xqplfly/uart-wifi-transmissible/web_server.ino

// ==================== Web服务器和页面处理 ====================

void initWebServer() {
  if (webServerEnabled && (wifiConnected || currentMode == MODE_SERVER)) {
    webServer.begin();
    if (debugMode) {
      Serial.println("✓ Web服务器启动成功");
      Serial.println("  管理页面已就绪");
    }
  }
}

void handleWebServer() {
  if (!webServerEnabled) return;

  const size_t maxHeaderLength = 1024;
  const size_t maxBodyLength = 1536;
  
  WiFiClient client = webServer.available();
  if (!client) return;
  
  // 先读取请求行和请求头
  String request = "";
  bool headersComplete = false;
  unsigned long startTime = millis();
  
  while (client.connected() && !headersComplete && (millis() - startTime < 500)) {
    if (client.available()) {
      char c = client.read();
      if (request.length() >= maxHeaderLength) {
        client.println("HTTP/1.1 413 Payload Too Large");
        client.println("Connection: close");
        client.println();
        client.stop();
        return;
      }
      request += c;
      
      if (request.length() >= 4 && request.substring(request.length() - 4) == "\r\n\r\n") {
        headersComplete = true;
        break;
      }
    }
    yield();
  }
  
  // 解析Content-Length
  int contentLength = 0;
  int pos = request.indexOf("Content-Length:");
  if (pos >= 0) {
    int pos2 = request.indexOf("\r\n", pos);
    if (pos2 > pos) {
      String lenStr = request.substring(pos + 15, pos2);
      lenStr.trim();
      contentLength = lenStr.toInt();
    }
  }

  if (contentLength > (int)maxBodyLength) {
    client.println("HTTP/1.1 413 Payload Too Large");
    client.println("Connection: close");
    client.println();
    client.stop();
    return;
  }
  
  // 如果是POST请求，继续读取body
  String postBody = "";
  if (contentLength > 0) {
    int bodyStart = request.length();
    while (client.connected() && (millis() - startTime < 500)) {
      if (client.available()) {
        char c = client.read();
        if (postBody.length() >= maxBodyLength) {
          client.println("HTTP/1.1 413 Payload Too Large");
          client.println("Connection: close");
          client.println();
          client.stop();
          return;
        }
        postBody += c;
        if (postBody.length() >= contentLength) break;
      }
      yield();
    }
  }
  
  // 构建完整的请求用于路由
  String requestLine = request;
  int lineEnd = request.indexOf("\r\n");
  if (lineEnd > 0) {
    requestLine = request.substring(0, lineEnd);
  }
  
  // 路由处理
  if (requestLine.indexOf("GET / ") >= 0 || requestLine.indexOf("GET / HTTP") >= 0) {
    handleRootPage(client);
  } else if (requestLine.indexOf("GET /favicon") >= 0) {
    client.println("HTTP/1.1 204 No Content");
    client.println();
  } else if (requestLine.indexOf("GET /hotspot-detect.html") >= 0 || requestLine.indexOf("GET /connecttest.txt") >= 0) {
    client.println("HTTP/1.1 200 OK");
    client.println("Content-Type: text/html");
    client.println();
    client.print("<!DOCTYPE html><html><head><script>window.location.href='http://192.168.1.1/';</script></head><body></body></html>");
  } else if (requestLine.indexOf("GET /generate_204") >= 0 || requestLine.indexOf("GET /fwlink") >= 0) {
    // Android/Windows Captive Portal
    client.println("HTTP/1.1 204 No Content");
    client.println();
  } else if (requestLine.indexOf("GET /ncsi.txt") >= 0) {
    // Windows Captive Portal
    client.println("HTTP/1.1 200 OK");
    client.println("Content-Type: text/plain");
    client.println();
    client.print("Microsoft Connect Test");
  } else if (requestLine.indexOf("GET /serial ") >= 0 || requestLine.indexOf("GET /serial") >= 0) {
    if (requestLine.indexOf("GET /serial/data") >= 0) {
      handleSerialDataAPI(client, requestLine);
    } else {
      handleSerialPage(client);
    }
  } else if (requestLine.indexOf("POST /serial/send") >= 0) {
    handleSerialSend(client, postBody);
  } else if (requestLine.indexOf("POST /serial/clear") >= 0) {
    handleSerialClear(client, postBody);
  } else if (requestLine.indexOf("GET /logs") >= 0) {
    handleLogsPage(client, request);
  } else if (requestLine.indexOf("GET /preview") >= 0) {
    handlePreviewLog(client, request);
  } else if (requestLine.indexOf("GET /status ") >= 0) {
    handleStatusPage(client);
  } else if (requestLine.indexOf("GET /client") >= 0) {
    handleClientPage(client, request);
  } else if (requestLine.indexOf("POST /client/send") >= 0) {
    handleClientSend(client, postBody);
  } else if (requestLine.indexOf("GET /config ") >= 0) {
    handleConfigPage(client);
  } else if (requestLine.indexOf("POST /saveconfig") >= 0) {
    handleSaveConfig(client, postBody);
  } else if (requestLine.indexOf("GET /download") >= 0) {
    handleDownloadLog(client, request);
  } else if (requestLine.indexOf("GET /clear ") >= 0) {
    handleClearLog(client);
  } else if (requestLine.indexOf("GET /deletedir") >= 0) {
    handleDeleteDirectory(client, request);
  } else if (requestLine.indexOf("GET /delete?file=") >= 0) {
    handleDeleteFile(client, request);
  } else if (requestLine.indexOf("POST /power") >= 0) {
    handlePowerControl(client, postBody);
  } else {
    handleNotFound(client);
  }
  
  delay(10);
  client.stop();
  yield();
}

void handleRootPage(WiFiClient client) {
  String html = "HTTP/1.1 200 OK\r\nContent-Type: text/html\r\n\r\n";
  html += "<!DOCTYPE html><html><head><meta charset='UTF-8'>";
  html += "<meta name='viewport' content='width=device-width, initial-scale=1.0, user-scalable=yes'>";
  html += "<title>ESP32 UART 服务器</title>";
  html += "<style>body{font-family:Arial,sans-serif;margin:10px;background:#f5f5f5;font-size:14px;}";
  html += ".container{max-width:100%;margin:0 auto;background:white;padding:12px;border-radius:10px;box-sizing:border-box;box-shadow:0 2px 8px rgba(0,0,0,0.1);}";
  html += "h1{color:#333;border-bottom:2px solid #4CAF50;padding-bottom:8px;font-size:18px;}";
  html += "h2{font-size:16px;}";
  html += "h3{font-size:15px;}";
  html += ".menu{margin:15px 0;display:flex;flex-wrap:wrap;gap:8px;}";
  html += ".menu a{display:block;padding:10px 12px;margin:0;background:#4CAF50;color:white;text-decoration:none;border-radius:4px;text-align:center;font-size:13px;flex:1 1 100px;transition:all 0.2s ease;}";
  html += ".menu a:hover{background:#45a049;transform:translateY(-1px);box-shadow:0 2px 5px rgba(0,0,0,0.2);}";
  html += ".info{background:#e7f3fe;border-left:4px solid #2196F3;padding:10px;margin:12px 0;font-size:13px;}";
  html += "strong{font-size:14px;}";
  html += ".power-controls{display:flex;flex-wrap:wrap;gap:8px;margin-top:10px;}";
  html += ".power-controls form{flex:1 1 80px;}";
  html += ".power-controls input[type='submit']{width:100%;padding:6px 10px;border:none;border-radius:4px;background:#2196F3;color:white;font-size:12px;cursor:pointer;transition:all 0.2s ease;}";
  html += ".power-controls input[type='submit']:hover{background:#1976D2;transform:translateY(-1px);}";
  html += "@media screen and (min-width: 600px) {";
  html += ".container{max-width:800px;padding:15px;}";
  html += ".menu a{flex:none;margin:5px;}";
  html += ".power-controls form{flex:none;width:auto;}";
  html += ".power-controls input[type='submit']{width:80px;}";
  html += "}";
  html += "@media screen and (max-width: 480px) {";
  html += ".menu a{flex:1 1 100%;font-size:12px;padding:8px 10px;}";
  html += ".container{max-width:95%;padding:10px;}";
  html += "h1{font-size:16px;}";
  html += "h3{font-size:14px;}";
  html += "}";
  html += "</style></head><body>";
  html += "<div class='container'>";
  html += "<h1>📡 ESP32 UART 服务器</h1>";
  html += "<div class='info'>";
  html += "<strong>固件版本:</strong> " + String(FIRMWARE_VERSION) + "<br>";
  html += "<strong>运行模式:</strong> " + String(currentMode == MODE_CLIENT ? "客户端" : "服务器") + "<br>";
  html += "<strong>WiFi状态:</strong> " + String(wifiConnected ? "已连接" : "未连接") + "<br>";
  html += "<strong>SD卡状态:</strong> " + String(sdCardReady ? "正常" : "异常") + "<br>";
  html += "<strong>UART1↔UART2透传:</strong> 已启用<br>";  // 透传功能
  html += "</div>";
  html += "<div class='menu'>";
  html += "<a href='/serial'>🖥️ 串口监视器</a>";
  html += "<a href='/logs'>📋 查看日志</a>";
  html += "<a href='/status'>📊 系统状态</a>";
  html += "<a href='/config'>⚙️ 系统配置</a>";
  html += "</div>";
  
  // 电源控制
  html += "<div class='info'>";
  html += "<h3>电源控制</h3>";
  html += "<div class='power-controls'>";
  html += "<form action='/power' method='post'>";
  html += "<input type='hidden' name='action' value='on'>";
  html += "<input type='submit' value='开机'>";
  html += "</form>";
  html += "<form action='/power' method='post'>";
  html += "<input type='hidden' name='action' value='off'>";
  html += "<input type='submit' value='关机'>";
  html += "</form>";
  html += "<form action='/power' method='post'>";
  html += "<input type='hidden' name='action' value='trigger'>";
  html += "<input type='submit' value='触发关机'>";
  html += "</form>";
  html += "<form action='/power' method='post'>";
  html += "<input type='hidden' name='action' value='reset'>";
  html += "<input type='submit' value='复位'>";
  html += "</form>";
  html += "</div>";
  html += "</div>";
  html += "</div>";
  html += "</body></html>";
  client.print(html);
}

void handleLogsPage(WiFiClient client, String request) {
  String html = "HTTP/1.1 200 OK\r\nContent-Type: text/html\r\n\r\n";
  html += "<!DOCTYPE html><html><head><meta charset='UTF-8'>";
  html += "<meta name='viewport' content='width=device-width, initial-scale=1.0, user-scalable=yes'>";
  html += "<title>ESP32 UART 日志</title>";
  html += "<style>body{font-family:Arial,sans-serif;margin:10px;background:#f5f5f5;font-size:14px;}";
  html += ".container{max-width:100%;margin:0 auto;background:white;padding:12px;border-radius:10px;box-sizing:border-box;box-shadow:0 2px 8px rgba(0,0,0,0.1);}";
  html += "h1{color:#333;border-bottom:2px solid #4CAF50;padding-bottom:8px;font-size:18px;}";
  html += "h2{font-size:16px;word-break:break-all;line-height:1.4;margin:10px 0;}";
  html += ".file-list{margin:15px 0;}";
  html += ".file-item{padding:10px;border-bottom:1px solid #eee;display:flex;align-items:center;justify-content:space-between;flex-wrap:wrap;}";
  html += ".file-name{flex:1;min-width:150px;word-break:break-all;overflow:hidden;text-overflow:ellipsis;white-space:nowrap;max-width:0;}";
  html += ".file-name a{text-decoration:none;color:#333;font-size:13px;}";
  html += ".file-name a:hover{color:#4CAF50;}";
  html += ".file-actions{display:flex;gap:8px;flex-shrink:0;margin-left:10px;}";
  html += ".file-actions a{padding:6px 12px;background:#2196F3;color:white;text-decoration:none;border-radius:4px;font-size:12px;transition:all 0.2s ease;}";
  html += ".file-actions a:hover{background:#1976D2;transform:translateY(-1px);}";
  html += ".file-size{color:#666;font-size:12px;margin-left:10px;flex-shrink:0;}";
  html += ".back{margin-top:15px;}";
  html += ".back a{display:inline-block;padding:8px 16px;background:#4CAF50;color:white;text-decoration:none;border-radius:4px;font-size:13px;transition:all 0.2s ease;}";
  html += ".back a:hover{background:#45a049;transform:translateY(-1px);}";
  html += ".breadcrumb{margin:10px 0;padding:8px;background:#f8f8f8;border-radius:4px;font-size:13px;}";
  html += ".breadcrumb a{text-decoration:none;color:#2196F3;}";
  html += ".breadcrumb a:hover{text-decoration:underline;}";
  html += "@media screen and (min-width: 600px) {";
  html += ".container{max-width:800px;padding:15px;}";
  html += "}";
  html += "@media screen and (max-width: 480px) {";
  html += ".file-item{flex-direction:row;align-items:center;}";
  html += ".file-actions{margin-left:auto;}";
  html += ".file-size{margin-left:10px;}";
  html += ".container{max-width:95%;padding:10px;}";
  html += "h1{font-size:16px;}";
  html += "h2{font-size:14px;}";
  html += "}";
  html += "</style></head><body>";
  html += "<div class='container'>";
  html += "<h1>📋 日志文件</h1>";
  html += "<div style='margin:10px 0;'>";
  html += "<a href='/logs?dir=server' style='padding:8px 16px;background:#4CAF50;color:white;text-decoration:none;border-radius:4px;'>服务器日志</a> ";
  html += "<a href='/logs?dir=client' style='padding:8px 16px;background:#2196F3;color:white;text-decoration:none;border-radius:4px;'>客户端日志</a>";
  html += "</div>";
  
  // 检查SD卡状态
  if (!sdCardReady) {
    html += "<div style='background:#ffebee;border-left:4px solid #f44336;padding:15px;margin:15px 0;'>";
    html += "<strong>错误:</strong> SD卡未就绪，无法查看日志文件";
    html += "</div>";
  } else {
    // 解析目录参数
    String currentDir = "/server";
    int dirIndex = request.indexOf("dir=");
    if (dirIndex > 0) {
      int dirEnd = request.indexOf(" ", dirIndex);
      if (dirEnd < 0) dirEnd = request.length();
      String dirParam = request.substring(dirIndex + 4, dirEnd);
      // 规范化：移除可能存在的前导斜杠
      while (dirParam.startsWith("/")) {
        dirParam = dirParam.substring(1);
      }
      // 规范化：移除可能存在的双斜杠
      while (dirParam.indexOf("//") >= 0) {
        dirParam.replace("//", "/");
      }
      // 安全检查：防止路径遍历攻击
      if (dirParam.indexOf("..") == -1) {
        if (dirParam == "client") {
          currentDir = "/client";
        } else if (dirParam == "server") {
          currentDir = "/server";
        } else if (dirParam.startsWith("client/")) {
          currentDir = "/" + dirParam;
        } else if (dirParam.startsWith("server/")) {
          currentDir = "/" + dirParam;
        } else if (dirParam.length() > 0) {
          // 判断是服务器还是客户端的子目录，需要从父路径判断
          // 默认先尝试服务器目录
          if (SD.exists("/server/" + dirParam)) {
            currentDir = "/server/" + dirParam;
          } else if (SD.exists("/client/" + dirParam)) {
            currentDir = "/client/" + dirParam;
          } else {
            // 如果都不存在，默认为客户端目录
            currentDir = "/client/" + dirParam;
          }
        }
      }
    }
    
    // 面包屑导航
    html += "<div class='breadcrumb'>";
    html += "<a href='/logs'>根目录</a>";
    if (currentDir.startsWith("/server")) {
      html += " → <a href='/logs?dir=server'>服务器</a>";
      if (currentDir != "/server") {
        String subPath = currentDir.substring(8); // 去掉 "/server" 前缀
        if (subPath.length() > 0 && subPath != "/") {
          html += " → " + subPath;
        }
      }
    } else if (currentDir.startsWith("/client")) {
      html += " → <a href='/logs?dir=client'>客户端</a>";
      String subPath = currentDir.substring(7); // 去掉 "/client" 前缀
      if (subPath.length() > 0 && subPath != "/") {
        // 移除前导斜杠
        if (subPath.startsWith("/")) {
          subPath = subPath.substring(1);
        }
        html += " → " + subPath;
      }
    }
    html += "</div>";
    
    // 列出当前目录内容
    String displayDir = currentDir;
    if (displayDir.length() > 50) {
      displayDir = "..." + displayDir.substring(displayDir.length() - 47);
    }
    html += "<h2>" + displayDir + "</h2>";
    html += "<div class='file-list'>";
    File root = SD.open(currentDir);
    if (root) {
      bool hasFiles = false;
      
      // 显示返回上级目录链接
      if (currentDir != "/server" && currentDir != "/client") {
        String parentDir = currentDir.substring(0, currentDir.lastIndexOf('/'));
        String parentLink = "";
        if (parentDir == "/server") {
          parentLink = "/logs?dir=server";
        } else if (parentDir == "/client") {
          parentLink = "/logs?dir=client";
        } else if (parentDir.startsWith("/server")) {
          parentLink = "/logs?dir=" + parentDir.substring(8);
        } else {
          parentLink = "/logs?dir=" + parentDir.substring(1);
        }
        html += "<div class='file-item'>";
        html += "<div class='file-name'>";
        html += "<a href='" + parentLink + "'>📁 .. (返回上级)</a>";
        html += "</div>";
        html += "</div>";
      }
      
      while (true) {
        File entry = root.openNextFile();
        if (!entry) break;
        hasFiles = true;
        String entryName = entry.name();
        // 规范化路径：避免产生双斜杠
        String entryPath;
        if (currentDir.endsWith("/")) {
          entryPath = currentDir + entryName;
        } else {
          entryPath = currentDir + "/" + entryName;
        }
        // 移除路径中可能存在的双斜杠
        while (entryPath.indexOf("//") >= 0) {
          entryPath.replace("//", "/");
        }
        String entryUrlPath;
        if (currentDir.startsWith("/server")) {
          entryUrlPath = entryPath.substring(8); // 去掉 "/server" 前缀
        } else {
          entryUrlPath = entryPath.substring(7); // 去掉 "/client" 前缀
        }
        
        if (entry.isDirectory()) {
          html += "<div class='file-item'>";
          html += "<div class='file-name'>";
          html += "<a href='/logs?dir=" + entryUrlPath + "'>📁 " + entryName + "</a>";
          html += "</div>";
          html += "<div class='file-actions'>";
          html += "<a href='/deletedir?dir=" + entryPath + "' onclick='return confirm(\"确定删除文件夹 " + entryName + " 及所有内容？\")' style='background:#f44336;'>删除</a>";
          html += "</div>";
          html += "</div>";
        } else {
          String fileSize = formatFileSize(entry.size());
          html += "<div class='file-item'>";
          html += "<div class='file-name'>📄 " + entryName + "</div>";
          html += "<div class='file-actions'>";
          html += "<a href='/preview?file=" + entryPath + "'>预览</a>";
          html += "<a href='/download?file=" + entryPath + "'>下载</a>";
          html += "<a href='/delete?file=" + entryPath + "' onclick='return confirm(\"确定删除 " + entryName + "？\")'>删除</a>";
          html += "</div>";
          html += "<div class='file-size'>" + fileSize + "</div>";
          html += "</div>";
        }
        entry.close();
      }
      if (!hasFiles) {
        html += "<div class='file-item'><div class='file-name'>空目录</div></div>";
      }
      root.close();
    } else {
      html += "<div style='background:#ffebee;border-left:4px solid #f44336;padding:15px;margin:15px 0;'>";
      html += "<strong>错误:</strong> 无法打开目录: " + currentDir;
      html += "</div>";
    }
    html += "</div>";
  }
  
  html += "<div class='back'><a href='/'>返回首页</a></div>";
  html += "</div>";
  html += "</body></html>";
  client.print(html);
}

void handleStatusPage(WiFiClient client) {
  String html = "HTTP/1.1 200 OK\r\nContent-Type: text/html\r\n\r\n";
  html += "<!DOCTYPE html><html><head><meta charset='UTF-8'>";
  html += "<meta name='viewport' content='width=device-width, initial-scale=1.0, user-scalable=yes'>";
  html += "<title>ESP32 UART 系统状态</title>";
  html += "<style>body{font-family:Arial,sans-serif;margin:10px;background:#f5f5f5;font-size:14px;}";
  html += ".container{max-width:100%;margin:0 auto;background:white;padding:12px;border-radius:10px;box-sizing:border-box;box-shadow:0 2px 8px rgba(0,0,0,0.1);}";
  html += "h1{color:#333;border-bottom:2px solid #4CAF50;padding-bottom:8px;font-size:18px;}";
  html += "h2{font-size:16px;}";
  html += ".status{background:#e7f3fe;border-left:4px solid #2196F3;padding:10px;margin:12px 0;font-size:13px;}";
  html += "strong{font-size:14px;}";
  html += ".back{margin-top:15px;}";
  html += ".back a{display:inline-block;padding:8px 16px;background:#4CAF50;color:white;text-decoration:none;border-radius:4px;font-size:13px;transition:all 0.2s ease;}";
  html += ".back a:hover{background:#45a049;transform:translateY(-1px);}";
  html += "@media screen and (min-width: 600px) {";
  html += ".container{max-width:800px;padding:15px;}";
  html += "}";
  html += "@media screen and (max-width: 480px) {";
  html += ".container{max-width:95%;padding:10px;}";
  html += "h1{font-size:16px;}";
  html += "h2{font-size:14px;}";
  html += "}";
  html += "</style></head><body>";
  html += "<div class='container'>";
  html += "<h1>📊 系统状态</h1>";
  
  // 系统信息
  html += "<div class='status'>";
  html += "<strong>固件版本:</strong> " + String(FIRMWARE_VERSION) + "<br>";
  html += "<strong>运行模式:</strong> " + String(currentMode == MODE_CLIENT ? "客户端" : "服务器") + "<br>";
  html += "<strong>客户端ID:</strong> " + client_id + "<br>";
  html += "<strong>运行时间:</strong> " + String(millis() / 1000) + " 秒<br>";
  html += "</div>";
  
  // WiFi信息
  html += "<div class='status'>";
  html += "<h2>WiFi信息</h2>";
  html += "<strong>状态:</strong> " + String(wifiConnected ? "已连接" : "未连接") + "<br>";
  if (wifiConnected) {
    if (currentMode == MODE_SERVER) {
      html += "<strong>AP SSID:</strong> " + maskSensitiveValue(ap_ssid) + "<br>";
      html += "<strong>AP 地址:</strong> " + maskIpAddress(WiFi.softAPIP()) + "<br>";
      html += "<strong>连接设备数:</strong> " + String(WiFi.softAPgetStationNum()) + "<br>";
    } else {
      html += "<strong>SSID:</strong> " + maskSensitiveValue(client_wifi_ssid) + "<br>";
      html += "<strong>IP地址:</strong> " + maskIpAddress(WiFi.localIP()) + "<br>";
      html += "<strong>信号强度:</strong> " + String(WiFi.RSSI()) + " dBm<br>";
    }
  }
  html += "</div>";
  
  // 串口信息
  html += "<div class='status'>";
  html += "<h2>串口信息</h2>";
  html += "<strong>UART2波特率:</strong> " + String(uart2BaudRate) + "<br>";
  html += "<strong>UART2引脚:</strong> RX=" + String(UART2_RX_PIN) + " TX=" + String(UART2_TX_PIN) + "<br>";
  html += "<strong>UART1波特率:</strong> " + String(uart1BaudRate) + "<br>";
  html += "<strong>UART1引脚:</strong> RX=" + String(UART1_RX_PIN) + " TX=" + String(UART1_TX_PIN) + "<br>";
  html += "</div>";
  
  // SD卡信息
  html += "<div class='status'>";
  html += "<h2>SD卡信息</h2>";
  html += "<strong>状态:</strong> " + String(sdCardReady ? "正常" : "异常") + "<br>";
  if (sdCardReady) {
    uint64_t cardSize = SD.cardSize() / (1024 * 1024);
    uint64_t usedSize = SD.usedBytes() / (1024 * 1024);
    html += "<strong>总容量:</strong> " + String(cardSize) + " MB<br>";
    html += "<strong>已用容量:</strong> " + String(usedSize) + " MB<br>";
  }
  html += "</div>";
  
  // 电池信息
  html += "<div class='status'>";
  html += "<h2>电池信息</h2>";
  html += "<strong>电池电压:</strong> " + String(batteryVoltage) + " V<br>";
  html += "<strong>状态:</strong> " + String(batteryVoltage > BATTERY_LOW_VOLTAGE ? "正常" : "低电压") + "<br>";
  html += "</div>";
  
  // 客户端连接信息（服务器模式）
  if (currentMode == MODE_SERVER) {
    int clientCount = getConnectedClientCount();
    html += "<div class='status'>";
    html += "<h2>客户端连接</h2>";
    html += "<strong>当前连接数:</strong> " + String(clientCount) + "<br>";
    for (int i = 0; i < MAX_CLIENTS; i++) {
      if (serverClients[i] && serverClients[i].connected()) {
        html += "<a href='/client?client_id=" + String(i) + "' style='display:inline-block;padding:8px 12px;background:#4CAF50;color:white;text-decoration:none;border-radius:4px;margin:5px 0;'>";
        html += "客户端 " + String(i) + ": " + maskIpAddress(serverClients[i].remoteIP()) + " → 点击查看数据</a><br>";
      }
    }
    if (clientCount == 0) {
      html += "<em>暂无客户端连接</em><br>";
    }
    html += "</div>";
  }
  
  html += "<div class='back'><a href='/'>返回首页</a></div>";
  html += "</div>";
  html += "</body></html>";
  client.print(html);
}

void handleClientPage(WiFiClient client, String request) {
  // 解析客户端索引
  int clientIdx = -1;
  int idxStart = request.indexOf("client_id=") + 10;
  int idxEnd = request.indexOf("&", idxStart);
  if (idxEnd == -1) idxEnd = request.length();
  String clientIdParam = request.substring(idxStart, idxEnd);
  clientIdx = clientIdParam.toInt();
  
  // 检查刷新请求
  bool isRefresh = (request.indexOf("refresh=1") > 0);
  
  if (isRefresh) {
    // 返回纯文本数据用于AJAX刷新
    client.println("HTTP/1.1 200 OK");
    client.println("Content-Type: text/plain");
    client.println();
    
    if (clientIdx >= 0 && clientIdx < MAX_CLIENTS) {
      String filteredData = filterAnsiEscape(clientSerialData[clientIdx]);
      client.print(filteredData);
    }
    return;
  }
  
  // 检查客户端是否有效
  if (clientIdx < 0 || clientIdx >= MAX_CLIENTS || !serverClients[clientIdx] || !serverClients[clientIdx].connected()) {
    client.println("HTTP/1.1 200 OK\r\nContent-Type: text/html\r\n\r\n");
    client.print("<!DOCTYPE html><html><head><meta charset='UTF-8'></head><body>");
    client.print("<h1>客户端不存在或已断开</h1>");
    client.print("<a href='/'>返回首页</a></body></html>");
    return;
  }
  
  String html = "HTTP/1.1 200 OK\r\nContent-Type: text/html\r\n\r\n";
  html += "<!DOCTYPE html><html><head><meta charset='UTF-8'>";
  html += "<meta name='viewport' content='width=device-width, initial-scale=1.0, user-scalable=yes'>";
  html += "<title>客户端 " + String(clientIdx) + " - ESP32 UART</title>";
  html += "<style>";
  html += "*{box-sizing:border-box;margin:0;padding:0;}";
  html += "body{font-family:'Consolas','Monaco',monospace;margin:0;background:#1e1e1e;color:#0f0;height:100vh;display:flex;flex-direction:column;}";
  html += ".header{background:#2d2d2d;padding:12px 15px;border-bottom:1px solid #444;}";
  html += ".header h1{color:#4CAF50;font-size:18px;}";
  html += ".header-info{color:#888;font-size:12px;margin-top:5px;}";
  html += ".serial-container{flex:1;display:flex;flex-direction:column;overflow:hidden;}";
  html += ".serial-output{flex:1;background:#1a1a1a;color:#0f0;padding:12px;overflow-y:auto;font-size:13px;line-height:1.5;word-wrap:break-word;white-space:pre-wrap;border:none;resize:none;}";
  html += ".serial-output::-webkit-scrollbar{width:10px;}";
  html += ".serial-output::-webkit-scrollbar-track{background:#2d2d2d;}";
  html += ".serial-output::-webkit-scrollbar-thumb{background:#555;border-radius:5px;}";
  html += ".input-area{background:#2d2d2d;padding:12px;display:flex;gap:8px;border-top:1px solid #444;}";
  html += ".input-area input[type='text']{flex:1;padding:10px 12px;background:#333;color:#fff;border:1px solid #555;border-radius:4px;font-size:14px;font-family:inherit;}";
  html += ".input-area input[type='text']:focus{outline:none;border-color:#4CAF50;}";
  html += ".input-area input[type='submit']{padding:10px 20px;background:#4CAF50;color:white;border:none;border-radius:4px;font-size:14px;cursor:pointer;transition:all 0.2s;}";
  html += ".input-area input[type='submit']:hover{background:#45a049;}";
  html += ".back-btn{background:#2196F3 !important;}";
  html += ".back-btn:hover{background:#1976D2 !important;}";
  html += "@media screen and (max-width: 600px){";
  html += ".input-area{flex-direction:column;}";
  html += ".input-area input[type='submit']{width:100%;}";
  html += ".serial-output{font-size:12px;}";
  html += "}";
  html += "</style></head><body>";
  html += "<div class='header'>";
  html += "<h1>🖥️ 客户端 " + String(clientIdx) + " - 串口数据</h1>";
  html += "<div class='header-info'>终端: " + maskIpAddress(serverClients[clientIdx].remoteIP()) + " | 波特率: " + String(uart2BaudRate) + "</div>";
  html += "</div>";
  html += "<div class='serial-container'>";
  String initData = filterAnsiEscape(clientSerialData[clientIdx]);
  html += "<textarea class='serial-output' id='serialData' readonly>" + initData + "</textarea>";
  html += "</div>";
  html += "<div class='input-area'>";
  html += "<input type='text' id='serialInput' placeholder='输入命令...' autocomplete='off'>";
  html += "<label style='color:#fff;font-size:12px;white-space:nowrap;'><input type='checkbox' id='addCr' style='margin-right:4px;'>CR(\\r)</label>";
  html += "<label style='color:#fff;font-size:12px;white-space:nowrap;'><input type='checkbox' id='addLf' checked style='margin-right:4px;'>LF(\\n)</label>";
  html += "<input type='submit' value='发送' onclick='sendData()'>";
  html += "<input type='submit' value='返回' class='back-btn' onclick=\"location.href='/'\">";
  html += "</div>";
  html += "<script>";
  html += "var clientIdx = " + String(clientIdx) + ";";
  html += "function fetchSerialData(){";
  html += "  var xhr = new XMLHttpRequest();";
  html += "  xhr.open('GET', '/client?client_id=" + String(clientIdx) + "&refresh=1', true);";
  html += "  xhr.onreadystatechange = function(){";
  html += "    if(xhr.readyState == 4 && xhr.status == 200){";
  html += "      var data = xhr.responseText;";
  html += "      if(data.length > 0){";
  html += "        var output = document.getElementById('serialData');";
  html += "        var wasAtBottom = output.scrollHeight - output.scrollTop <= output.clientHeight + 50;";
  html += "        output.value = data;";
  html += "        if(wasAtBottom){";
  html += "          output.scrollTop = output.scrollHeight;";
  html += "        }";
  html += "      }";
  html += "    }";
  html += "  };";
  html += "  xhr.send();";
  html += "}";
  html += "function sendData(){";
  html += "  var input = document.getElementById('serialInput');";
  html += "  var addCr = document.getElementById('addCr').checked ? '1' : '0';";
  html += "  var addLf = document.getElementById('addLf').checked ? '1' : '0';";
  html += "  var xhr = new XMLHttpRequest();";
  html += "  xhr.open('POST', '/client/send?client_id=" + String(clientIdx) + "', true);";
  html += "  xhr.setRequestHeader('Content-Type', 'application/x-www-form-urlencoded');";
  html += "  xhr.send('data=' + encodeURIComponent(input.value) + '&cr=' + addCr + '&lf=' + addLf);";
  html += "  input.value = '';";
  html += "}";
  html += "document.getElementById('serialInput').addEventListener('keypress', function(e){";
  html += "  if(e.key === 'Enter'){";
  html += "    sendData();";
  html += "    e.preventDefault();";
  html += "  }";
  html += "});";
  html += "document.getElementById('serialData').scrollTop = document.getElementById('serialData').scrollHeight;";
  html += "setInterval(fetchSerialData, 50);";
  html += "</script>";
  html += "</body></html>";
  client.print(html);
}

void handleClientSend(WiFiClient client, String request) {
  int clientIdx = -1;
  int idxStart = request.indexOf("client_id=") + 10;
  int idxEnd = request.indexOf("&", idxStart);
  if (idxEnd == -1) idxEnd = request.length();
  String clientIdxStr = request.substring(idxStart, idxEnd);
  clientIdx = clientIdxStr.toInt();
  
  int dataIndex = request.indexOf("data=") + 5;
  int dataEnd = request.indexOf("&", dataIndex);
  if (dataEnd == -1) dataEnd = request.length();
  String data = request.substring(dataIndex, dataEnd);
  data = urlDecode(data);
  
  bool addCr = false;
  int crPos = request.indexOf("cr=");
  if (crPos >= 0) {
    crPos += 3;
    addCr = (request.charAt(crPos) == '1');
  }
  
  bool addLf = true;
  int lfPos = request.indexOf("lf=");
  if (lfPos >= 0) {
    lfPos += 3;
    addLf = (request.charAt(lfPos) == '1');
  }
  
  if (addCr) data += "\r";
  if (addLf) data += "\n";
  
  if (clientIdx >= 0 && clientIdx < MAX_CLIENTS && serverClients[clientIdx] && serverClients[clientIdx].connected()) {
    if (data.length() > 0) {
      String payload = "";
      String frame = buildSecureFrame(data);
      String errorReason = "";

      webFrameBuffer = "";
      if (frame.length() > 0 && appendIngressChunk(SECURITY_SOURCE_WEB, -1, (const uint8_t *)frame.c_str(), frame.length(), errorReason) &&
          getValidatedPayload(SECURITY_SOURCE_WEB, -1, payload, errorReason)) {
        sendFramedPayloadToClient(serverClients[clientIdx], payload);
      }
    }
  }
  
  String html = "HTTP/1.1 200 OK\r\nContent-Type: text/html\r\n\r\n";
  html += "<!DOCTYPE html><html><head><meta http-equiv='refresh' content='0;url=/client?client_id=" + String(clientIdx) + "'></head></html>";
  client.print(html);
}

void handleConfigPage(WiFiClient client) {
  String html = "HTTP/1.1 200 OK\r\nContent-Type: text/html\r\n\r\n";
  html += "<!DOCTYPE html><html><head><meta charset='UTF-8'>";
  html += "<meta name='viewport' content='width=device-width, initial-scale=1.0, user-scalable=yes'>";
  html += "<title>ESP32 UART 系统配置</title>";
  html += "<style>body{font-family:Arial;margin:10px;background:#f0f0f0;font-size:16px;}";
  html += ".container{max-width:100%;margin:0 auto;background:white;padding:15px;border-radius:10px;box-sizing:border-box;}";
  html += "h1{color:#333;border-bottom:2px solid #4CAF50;padding-bottom:10px;font-size:24px;}";
  html += "h2{font-size:20px;}";
  html += ".form-group{margin:15px 0;}";
  html += ".form-group label{display:block;margin-bottom:5px;font-weight:bold;}";
  html += ".form-group input[type='text'], .form-group input[type='number'], .form-group select{width:100%;padding:10px;font-size:16px;box-sizing:border-box;}";
  html += ".form-group input[type='submit']{width:100%;padding:15px;font-size:18px;background:#4CAF50;color:white;border:none;border-radius:5px;cursor:pointer;}";
  html += ".form-group input[type='submit']:hover{background:#45a049;}";
  html += ".back{margin-top:20px;}";
  html += ".back a{display:inline-block;padding:10px 20px;background:#4CAF50;color:white;text-decoration:none;border-radius:5px;}";
  html += ".back a:hover{background:#45a049;}";
  html += "@media screen and (min-width: 600px) {";
  html += ".container{max-width:800px;padding:20px;}";
  html += "}";
  html += "</style></head><body>";
  html += "<div class='container'>";
  html += "<h1>⚙️ 系统配置</h1>";
  html += "<form action='/saveconfig' method='post'>";
  html += "<div class='form-group'><small style='color:#666;'>敏感配置不回显，留空表示保持当前值。</small></div>";
  
  // 运行模式
  html += "<div class='form-group'>";
  html += "<label for='mode'>运行模式</label>";
  html += "<select name='mode' id='mode'>";
  html += String("<option value='0'") + (currentMode == MODE_CLIENT ? " selected" : "") + ">客户端模式</option>";
  html += String("<option value='1'") + (currentMode == MODE_SERVER ? " selected" : "") + ">服务器模式</option>";
  html += "</select>";
  html += "</div>";
  
  // 客户端ID
  html += "<div class='form-group'>";
  html += "<label for='client_id'>客户端ID</label>";
  html += "<input type='text' name='client_id' id='client_id' value='" + client_id + "'>";
  html += "</div>";

  html += "<div class='form-group'>";
  html += "<label for='ap_ssid'>AP SSID</label>";
  html += "<input type='text' name='ap_ssid' id='ap_ssid' maxlength='32' placeholder='留空保持当前配置'>";
  html += "<small style='color:#888;display:block;margin-top:5px;'>当前: " + maskSensitiveValue(ap_ssid) + "</small>";
  html += "</div>";

  html += "<div class='form-group'>";
  html += "<label for='ap_password'>AP 密码</label>";
  html += "<input type='password' name='ap_password' id='ap_password' maxlength='63' placeholder='留空保持当前配置'>";
  html += "<small style='color:#888;display:block;margin-top:5px;'>状态: " + String(strlen(ap_password) >= 8 ? "已配置" : "未配置") + "</small>";
  html += "</div>";

  html += "<div class='form-group'>";
  html += "<label for='client_wifi_ssid'>客户端 WiFi SSID</label>";
  html += "<input type='text' name='client_wifi_ssid' id='client_wifi_ssid' maxlength='32' placeholder='留空保持当前配置'>";
  html += "<small style='color:#888;display:block;margin-top:5px;'>当前: " + maskSensitiveValue(client_wifi_ssid) + "</small>";
  html += "</div>";

  html += "<div class='form-group'>";
  html += "<label for='client_wifi_password'>客户端 WiFi 密码</label>";
  html += "<input type='password' name='client_wifi_password' id='client_wifi_password' maxlength='63' placeholder='留空保持当前配置'>";
  html += "<small style='color:#888;display:block;margin-top:5px;'>状态: " + String(strlen(client_wifi_password) >= 8 ? "已配置" : "未配置") + "</small>";
  html += "</div>";

  html += "<div class='form-group'>";
  html += "<label for='portal_ssid'>配网热点 SSID</label>";
  html += "<input type='text' name='portal_ssid' id='portal_ssid' maxlength='32' placeholder='留空保持当前配置'>";
  html += "<small style='color:#888;display:block;margin-top:5px;'>当前: " + maskSensitiveValue(wifimanager_ssid) + "</small>";
  html += "</div>";

  html += "<div class='form-group'>";
  html += "<label for='portal_password'>配网热点密码</label>";
  html += "<input type='password' name='portal_password' id='portal_password' maxlength='63' placeholder='留空保持当前配置'>";
  html += "<small style='color:#888;display:block;margin-top:5px;'>状态: " + String(strlen(wifimanager_password) >= 8 ? "已配置" : "未配置") + "</small>";
  html += "</div>";
  
  // UART2波特率
  html += "<div class='form-group'>";
  html += "<label for='uart2_baud'>UART2波特率</label>";
  html += "<select name='uart2_baud' id='uart2_baud'>";
  html += String("<option value='9600'") + (uart2BaudRate == 9600 ? " selected" : "") + ">9600</option>";
  html += String("<option value='19200'") + (uart2BaudRate == 19200 ? " selected" : "") + ">19200</option>";
  html += String("<option value='38400'") + (uart2BaudRate == 38400 ? " selected" : "") + ">38400</option>";
  html += String("<option value='57600'") + (uart2BaudRate == 57600 ? " selected" : "") + ">57600</option>";
  html += String("<option value='115200'") + (uart2BaudRate == 115200 ? " selected" : "") + ">115200</option>";
  html += "</select>";
  html += "</div>";
  
  // 调试模式
  html += "<div class='form-group'>";
  html += "<label for='debug_mode'>调试模式</label>";
  html += "<select name='debug_mode' id='debug_mode'>";
  html += String("<option value='1'") + (debugMode ? " selected" : "") + ">开启</option>";
  html += String("<option value='0'") + (!debugMode ? " selected" : "") + ">关闭</option>";
  html += "</select>";
  html += "</div>";
  
  // 日志时间戳
  html += "<div class='form-group'>";
  html += "<label for='log_timestamp'>日志时间戳</label>";
  html += "<select name='log_timestamp' id='log_timestamp'>";
  html += String("<option value='1'") + (logWithTimestamp ? " selected" : "") + ">开启 - 每行日志添加时间</option>";
  html += String("<option value='0'") + (!logWithTimestamp ? " selected" : "") + ">关闭</option>";
  html += "</select>";
  html += "<small style='color:#888;display:block;margin-top:5px;'>开启后在SD卡日志中每行数据前会添加时间戳 [HH:MM:SS.mmm]</small>";
  html += "</div>";
  
  // 保存按钮
  html += "<div class='form-group'>";
  html += "<input type='submit' value='保存配置'>";
  html += "</div>";
  html += "</form>";
  
  html += "<div class='back'><a href='/'>返回首页</a></div>";
  html += "</div>";
  html += "</body></html>";
  client.print(html);
}

void handleSaveConfig(WiFiClient client, String request) {
  String postData = request;
  String validationError = "";

  String modeValue = getFormValue(postData, "mode");
  int newMode = currentMode;
  if (modeValue.length() > 0) {
    newMode = modeValue.toInt();
    if (newMode != MODE_CLIENT && newMode != MODE_SERVER) {
      validationError = "运行模式无效";
    }
  }

  String newClientId = getFormValue(postData, "client_id");
  if (validationError.length() == 0 && !validateClientIdValue(newClientId)) {
    validationError = "客户端ID仅允许字母、数字、下划线和短横线";
  }

  String baudValue = getFormValue(postData, "uart2_baud");
  unsigned long newBaud = uart2BaudRate;
  if (validationError.length() == 0 && baudValue.length() > 0) {
    newBaud = baudValue.toInt();
    if (newBaud < 9600 || newBaud > 921600) {
      validationError = "UART2 波特率无效";
    }
  }

  String debugValue = getFormValue(postData, "debug_mode");
  bool newDebugMode = debugMode;
  if (validationError.length() == 0 && debugValue.length() > 0) {
    if (debugValue != "0" && debugValue != "1") {
      validationError = "调试模式参数无效";
    } else {
      newDebugMode = debugValue == "1";
    }
  }

  String logTimestampValue = getFormValue(postData, "log_timestamp");
  bool newLogTimestamp = logWithTimestamp;
  if (validationError.length() == 0 && logTimestampValue.length() > 0) {
    if (logTimestampValue != "0" && logTimestampValue != "1") {
      validationError = "日志时间戳参数无效";
    } else {
      newLogTimestamp = logTimestampValue == "1";
    }
  }

  char nextApSsid[sizeof(ap_ssid)] = {0};
  char nextApPassword[sizeof(ap_password)] = {0};
  char nextClientSsid[sizeof(client_wifi_ssid)] = {0};
  char nextClientPassword[sizeof(client_wifi_password)] = {0};
  char nextPortalSsid[sizeof(wifimanager_ssid)] = {0};
  char nextPortalPassword[sizeof(wifimanager_password)] = {0};

  copyStringToBuffer(String(ap_ssid), nextApSsid, sizeof(nextApSsid));
  copyStringToBuffer(String(ap_password), nextApPassword, sizeof(nextApPassword));
  copyStringToBuffer(String(client_wifi_ssid), nextClientSsid, sizeof(nextClientSsid));
  copyStringToBuffer(String(client_wifi_password), nextClientPassword, sizeof(nextClientPassword));
  copyStringToBuffer(String(wifimanager_ssid), nextPortalSsid, sizeof(nextPortalSsid));
  copyStringToBuffer(String(wifimanager_password), nextPortalPassword, sizeof(nextPortalPassword));

  String apSsidValue = getFormValue(postData, "ap_ssid");
  if (validationError.length() == 0 && apSsidValue.length() > 0) {
    if (!validateWiFiSsidValue(apSsidValue) || !copyStringToBuffer(apSsidValue, nextApSsid, sizeof(nextApSsid))) {
      validationError = "AP SSID 非法或过长";
    }
  }

  String apPasswordValue = getFormValue(postData, "ap_password");
  if (validationError.length() == 0 && apPasswordValue.length() > 0) {
    if (!validateWiFiPasswordValue(apPasswordValue, false) || !copyStringToBuffer(apPasswordValue, nextApPassword, sizeof(nextApPassword))) {
      validationError = "AP 密码必须为 8-63 位安全字符";
    }
  }

  String clientSsidValue = getFormValue(postData, "client_wifi_ssid");
  if (validationError.length() == 0 && clientSsidValue.length() > 0) {
    if (!validateWiFiSsidValue(clientSsidValue) || !copyStringToBuffer(clientSsidValue, nextClientSsid, sizeof(nextClientSsid))) {
      validationError = "客户端 WiFi SSID 非法或过长";
    }
  }

  String clientPasswordValue = getFormValue(postData, "client_wifi_password");
  if (validationError.length() == 0 && clientPasswordValue.length() > 0) {
    if (!validateWiFiPasswordValue(clientPasswordValue, false) || !copyStringToBuffer(clientPasswordValue, nextClientPassword, sizeof(nextClientPassword))) {
      validationError = "客户端 WiFi 密码必须为 8-63 位安全字符";
    }
  }

  String portalSsidValue = getFormValue(postData, "portal_ssid");
  if (validationError.length() == 0 && portalSsidValue.length() > 0) {
    if (!validateWiFiSsidValue(portalSsidValue) || !copyStringToBuffer(portalSsidValue, nextPortalSsid, sizeof(nextPortalSsid))) {
      validationError = "配网热点 SSID 非法或过长";
    }
  }

  String portalPasswordValue = getFormValue(postData, "portal_password");
  if (validationError.length() == 0 && portalPasswordValue.length() > 0) {
    if (!validateWiFiPasswordValue(portalPasswordValue, false) || !copyStringToBuffer(portalPasswordValue, nextPortalPassword, sizeof(nextPortalPassword))) {
      validationError = "配网热点密码必须为 8-63 位安全字符";
    }
  }

  if (validationError.length() == 0) {
    if (!validateWiFiSsidValue(String(nextApSsid)) || !validateWiFiPasswordValue(String(nextApPassword), false) ||
        !validateWiFiSsidValue(String(nextClientSsid)) || !validateWiFiPasswordValue(String(nextClientPassword), false) ||
        !validateWiFiSsidValue(String(nextPortalSsid)) || !validateWiFiPasswordValue(String(nextPortalPassword), false)) {
      validationError = "WiFi 配置不完整或不符合安全策略";
    }
  }

  if (validationError.length() > 0) {
    client.println("HTTP/1.1 400 Bad Request");
    client.println("Content-Type: text/html");
    client.println();
    client.print("<!DOCTYPE html><html><head><meta charset='UTF-8'></head><body><h1>配置保存失败</h1><p>");
    client.print(validationError);
    client.print("</p><a href='/config'>返回配置页</a></body></html>");
    return;
  }

  currentMode = newMode;
  client_id = newClientId;
  uart2BaudRate = newBaud;
  debugMode = newDebugMode;
  logWithTimestamp = newLogTimestamp;
  copyStringToBuffer(String(nextApSsid), ap_ssid, sizeof(ap_ssid));
  copyStringToBuffer(String(nextApPassword), ap_password, sizeof(ap_password));
  copyStringToBuffer(String(nextClientSsid), client_wifi_ssid, sizeof(client_wifi_ssid));
  copyStringToBuffer(String(nextClientPassword), client_wifi_password, sizeof(client_wifi_password));
  copyStringToBuffer(String(nextPortalSsid), wifimanager_ssid, sizeof(wifimanager_ssid));
  copyStringToBuffer(String(nextPortalPassword), wifimanager_password, sizeof(wifimanager_password));

  saveConfigToEEPROM();
  
  // 重启设备
  String html = "HTTP/1.1 200 OK\r\nContent-Type: text/html\r\n\r\n";
  html += "<!DOCTYPE html><html><head><meta charset='UTF-8'>";
  html += "<meta name='viewport' content='width=device-width, initial-scale=1.0, user-scalable=yes'>";
  html += "<title>配置保存成功</title>";
  html += "<style>body{font-family:Arial;margin:10px;background:#f0f0f0;font-size:16px;}";
  html += ".container{max-width:100%;margin:0 auto;background:white;padding:15px;border-radius:10px;box-sizing:border-box;}";
  html += "h1{color:#333;border-bottom:2px solid #4CAF50;padding-bottom:10px;font-size:24px;}";
  html += ".success{background:#e8f5e8;border-left:4px solid #4CAF50;padding:15px;margin:15px 0;font-size:16px;}";
  html += "@media screen and (min-width: 600px) {";
  html += ".container{max-width:800px;padding:20px;}";
  html += "}";
  html += "</style></head><body>";
  html += "<div class='container'>";
  html += "<h1>配置保存成功</h1>";
  html += "<div class='success'>";
  html += "<strong>配置已保存，设备将重启...</strong><br>";
  html += "运行模式: " + String(newMode == MODE_CLIENT ? "客户端" : "服务器") + "<br>";
  html += "客户端ID: " + newClientId + "<br>";
  html += "UART2波特率: " + String(newBaud) + "<br>";
  html += "调试模式: " + String(newDebugMode ? "开启" : "关闭") + "<br>";
  html += "WiFi 凭据: 已按安全策略更新或保持原值<br>";
  html += "</div>";
  html += "</div>";
  html += "</body></html>";
  client.print(html);

  // 延迟后重启
  delay(2000);
  ESP.restart();
}

void handleDownloadLog(WiFiClient client, String request) {
  // 解析文件路径
  int fileStart = request.indexOf("file=") + 5;
  int fileEnd = request.indexOf("&", fileStart);
  int spaceEnd = request.indexOf(" ", fileStart);
  if (fileEnd == -1 || (spaceEnd != -1 && spaceEnd < fileEnd)) {
    fileEnd = spaceEnd;
  }
  if (fileEnd == -1) fileEnd = request.length();
  String filePath = request.substring(fileStart, fileEnd);
  
  // URL解码
  filePath = urlDecode(filePath);
  
  // 安全检查：防止路径遍历攻击
  if (filePath.indexOf("..") != -1) {
    client.println("HTTP/1.1 403 Forbidden");
    client.println("Content-Type: text/html");
    client.println();
    client.println("<!DOCTYPE html><html><head><meta charset='UTF-8'></head><body><h1>403 - 禁止访问</h1><p>非法的文件路径</p><a href='/logs'>返回日志列表</a></body></html>");
    return;
  }
  
  // 打开文件
  File file = SD.open(filePath);
  if (file) {
    String fileName = filePath.substring(filePath.lastIndexOf('/') + 1);
    // 发送文件
    client.println("HTTP/1.1 200 OK");
    client.println("Content-Type: application/octet-stream");
    client.println("Content-Disposition: attachment; filename=\"" + fileName + "\"");
    client.println("Content-Length: " + String(file.size()));
    client.println();
    
    // 发送文件内容
    while (file.available()) {
      client.write(file.read());
    }
    file.close();
  } else {
    // 文件不存在
    client.println("HTTP/1.1 404 Not Found");
    client.println("Content-Type: text/html");
    client.println();
    client.println("<!DOCTYPE html><html><head><meta charset='UTF-8'></head><body><h1>404 - 文件未找到</h1><p>请求的文件不存在: " + filePath + "</p><a href='/logs'>返回日志列表</a></body></html>");
  }
}

void handleClearLog(WiFiClient client) {
  // 清除日志文件
  // 这里简化处理，实际应该根据需要删除特定文件
  
  String html = "HTTP/1.1 200 OK\r\nContent-Type: text/html\r\n\r\n";
  html += "<!DOCTYPE html><html><head><meta charset='UTF-8'>";
  html += "<meta name='viewport' content='width=device-width, initial-scale=1.0, user-scalable=yes'>";
  html += "<title>日志清除成功</title>";
  html += "<style>body{font-family:Arial;margin:10px;background:#f0f0f0;font-size:16px;}";
  html += ".container{max-width:100%;margin:0 auto;background:white;padding:15px;border-radius:10px;box-sizing:border-box;}";
  html += "h1{color:#333;border-bottom:2px solid #4CAF50;padding-bottom:10px;font-size:24px;}";
  html += ".success{background:#e8f5e8;border-left:4px solid #4CAF50;padding:15px;margin:15px 0;font-size:16px;}";
  html += ".back{margin-top:20px;}";
  html += ".back a{display:inline-block;padding:10px 20px;background:#4CAF50;color:white;text-decoration:none;border-radius:5px;}";
  html += ".back a:hover{background:#45a049;}";
  html += "@media screen and (min-width: 600px) {";
  html += ".container{max-width:800px;padding:20px;}";
  html += "}";
  html += "</style></head><body>";
  html += "<div class='container'>";
  html += "<h1>日志清除成功</h1>";
  html += "<div class='success'>";
  html += "<strong>日志文件已清除</strong>";
  html += "</div>";
  html += "<div class='back'><a href='/'>返回首页</a></div>";
  html += "</div>";
  html += "</body></html>";
  client.print(html);
}

void handlePowerControl(WiFiClient client, String request) {
  String postData = request;

  // 解析action参数
  int actionIndex = postData.indexOf("action=");
  if (actionIndex < 0) {
    client.println("HTTP/1.1 400 Bad Request");
    client.println("Content-Type: text/html");
    client.println();
    client.println("<!DOCTYPE html><html><head><meta charset='UTF-8'></head><body><h1>400 - 参数错误</h1><p>缺少 action 参数</p><a href='/'>返回首页</a></body></html>");
    return;
  }
  actionIndex += 7;
  int actionEnd = postData.indexOf("&", actionIndex);
  if (actionEnd == -1) actionEnd = postData.length();
  String action = postData.substring(actionIndex, actionEnd);
  action.trim();

  // 执行电源控制操作
  if (action == "on") {
    powerOn();
  } else if (action == "off") {
    powerOff();
  } else if (action == "trigger") {
    triggerShutdown();
  } else if (action == "reset") {
    resetCPU();
  } else {
    client.println("HTTP/1.1 400 Bad Request");
    client.println("Content-Type: text/html");
    client.println();
    client.println("<!DOCTYPE html><html><head><meta charset='UTF-8'></head><body><h1>400 - 参数错误</h1><p>未知 action: " + action + "</p><a href='/'>返回首页</a></body></html>");
    return;
  }

  // 返回结果
  String html = "HTTP/1.1 200 OK\r\nContent-Type: text/html\r\n\r\n";
  html += "<!DOCTYPE html><html><head><meta charset='UTF-8'>";
  html += "<meta name='viewport' content='width=device-width, initial-scale=1.0, user-scalable=yes'>";
  html += "<title>电源控制</title>";
  html += "<style>body{font-family:Arial;margin:10px;background:#f0f0f0;font-size:16px;}";
  html += ".container{max-width:100%;margin:0 auto;background:white;padding:15px;border-radius:10px;box-sizing:border-box;}";
  html += "h1{color:#333;border-bottom:2px solid #4CAF50;padding-bottom:10px;font-size:24px;}";
  html += ".success{background:#e8f5e8;border-left:4px solid #4CAF50;padding:15px;margin:15px 0;font-size:16px;}";
  html += ".back{margin-top:20px;}";
  html += ".back a{display:inline-block;padding:10px 20px;background:#4CAF50;color:white;text-decoration:none;border-radius:5px;}";
  html += ".back a:hover{background:#45a049;}";
  html += "@media screen and (min-width: 600px) {";
  html += ".container{max-width:800px;padding:20px;}";
  html += "}";
  html += "</style></head><body>";
  html += "<div class='container'>";
  html += "<h1>电源控制</h1>";
  html += "<div class='success'>";
  html += "<strong>操作已执行</strong><br>";
  if (action == "on") {
    html += "执行了开机操作";
  } else if (action == "off") {
    html += "执行了关机操作";
  } else if (action == "trigger") {
    html += "执行了触发关机操作";
  } else if (action == "reset") {
    html += "执行了复位操作";
  }
  html += "</div>";
  html += "<div class='back'><a href='/'>返回首页</a></div>";
  html += "</div>";
  html += "</body></html>";
  client.print(html);
}

void handleNotFound(WiFiClient client) {
  client.println("HTTP/1.1 404 Not Found");
  client.println("Content-Type: text/html");
  client.println();
  client.println("<!DOCTYPE html><html><head><meta charset='UTF-8'></head><body><h1>404 - 页面未找到</h1><p>请求的页面不存在</p><a href='/'>返回首页</a></body></html>");
}

// 格式化文件大小
String formatFileSize(unsigned long bytes) {
  if (bytes < 1024) {
    return String(bytes) + " B";
  } else if (bytes < 1024 * 1024) {
    return String(bytes / 1024.0, 1) + " KB";
  } else {
    return String(bytes / (1024.0 * 1024.0), 1) + " MB";
  }
}

// URL解码函数
String urlDecode(String input) {
  String result = "";
  for (unsigned int i = 0; i < input.length(); i++) {
    if (input.charAt(i) == '%') {
      if (i + 2 < input.length()) {
        char hex1 = input.charAt(i + 1);
        char hex2 = input.charAt(i + 2);
        int value = 0;
        if (hex1 >= '0' && hex1 <= '9') value += (hex1 - '0') * 16;
        else if (hex1 >= 'a' && hex1 <= 'f') value += (hex1 - 'a' + 10) * 16;
        else if (hex1 >= 'A' && hex1 <= 'F') value += (hex1 - 'A' + 10) * 16;
        
        if (hex2 >= '0' && hex2 <= '9') value += (hex2 - '0');
        else if (hex2 >= 'a' && hex2 <= 'f') value += (hex2 - 'a' + 10);
        else if (hex2 >= 'A' && hex2 <= 'F') value += (hex2 - 'A' + 10);
        
        result += (char)value;
        i += 2;
      } else {
        result += input.charAt(i);
      }
    } else if (input.charAt(i) == '+') {
      result += ' ';
    } else {
      result += input.charAt(i);
    }
  }
  return result;
}

String getFormValue(const String &body, const String &key) {
  String lookup = key + "=";
  int start = body.indexOf(lookup);
  if (start < 0) {
    return "";
  }

  start += lookup.length();
  int end = body.indexOf("&", start);
  if (end < 0) {
    end = body.length();
  }

  return urlDecode(body.substring(start, end));
}

// 处理日志预览（分页版本，流式读取避免栈溢出）
void handlePreviewLog(WiFiClient client, String request) {
  int fileStart = request.indexOf("file=") + 5;
  int fileEnd = request.indexOf("&", fileStart);
  int spaceEnd = request.indexOf(" ", fileStart);
  if (fileEnd == -1 || (spaceEnd != -1 && spaceEnd < fileEnd)) {
    fileEnd = spaceEnd;
  }
  if (fileEnd == -1) fileEnd = request.length();
  String filePath = request.substring(fileStart, fileEnd);
  
  filePath = urlDecode(filePath);
  
  while (filePath.indexOf("//") >= 0) {
    filePath.replace("//", "/");
  }
  
  if (filePath.indexOf("..") != -1) {
    client.println("HTTP/1.1 403 Forbidden");
    client.println("Content-Type: text/html");
    client.println();
    client.println("<!DOCTYPE html><html><head><meta charset='UTF-8'></head><body><h1>403 - 禁止访问</h1><p>非法的文件路径</p><a href='/logs'>返回日志列表</a></body></html>");
    return;
  }
  
  if (!filePath.startsWith("/server/") && !filePath.startsWith("/client/")) {
    client.println("HTTP/1.1 403 Forbidden");
    client.println("Content-Type: text/html");
    client.println();
    client.println("<!DOCTYPE html><html><head><meta charset='UTF-8'></head><body><h1>403 - 禁止访问</h1><p>非法的文件路径</p><a href='/logs'>返回日志列表</a></body></html>");
    return;
  }
  
  int page = -1;
  int pagePos = request.indexOf("page=");
  if (pagePos >= 0) {
    pagePos += 5;
    int pageEnd = request.indexOf("&", pagePos);
    int pageSpaceEnd = request.indexOf(" ", pagePos);
    if (pageEnd == -1 || (pageSpaceEnd != -1 && pageSpaceEnd < pageEnd)) {
      pageEnd = pageSpaceEnd;
    }
    if (pageEnd == -1) pageEnd = request.length();
    String pageStr = request.substring(pagePos, pageEnd);
    page = pageStr.toInt();
    if (page < 1) page = 1;
  }
  
  const int linesPerPage = 100;
  
  File file = SD.open(filePath);
  if (file) {
    String fileName = filePath.substring(filePath.lastIndexOf('/') + 1);
    unsigned long fileSize = file.size();
    
    int totalLines = 0;
    unsigned long lastYield = millis();
    while (file.available()) {
      if (file.read() == '\n') totalLines++;
      if (millis() - lastYield > 20) {
        yield();
        lastYield = millis();
      }
    }
    if (fileSize > 0) totalLines++;
    
    int totalPages = (totalLines + linesPerPage - 1) / linesPerPage;
    if (totalPages < 1) totalPages = 1;
    
    if (page < 0) page = totalPages;
    if (page > totalPages) page = totalPages;
    
    int startLine = (page - 1) * linesPerPage;
    
    file.seek(0);
    int currentLine = 0;
    unsigned long lastYield2 = millis();
    while (file.available() && currentLine < startLine) {
      if (file.read() == '\n') currentLine++;
      if (millis() - lastYield2 > 20) {
        yield();
        lastYield2 = millis();
      }
    }
    
    unsigned long pageStartPos = file.position();
    
    client.println("HTTP/1.1 200 OK");
    client.println("Content-Type: text/html");
    client.println();
    
    client.println("<!DOCTYPE html><html><head><meta charset='UTF-8'>");
    client.println("<meta name='viewport' content='width=device-width, initial-scale=1.0, user-scalable=yes'>");
    client.println("<title>预览: " + fileName + "</title>");
    client.println("<style>");
    client.println("*{box-sizing:border-box;margin:0;padding:0;}");
    client.println("body{font-family:Arial,sans-serif;margin:0;background:#f5f5f5;font-size:14px;}");
    client.println(".container{max-width:100%;margin:0 auto;background:white;padding:12px;border-radius:10px;box-sizing:border-box;box-shadow:0 2px 8px rgba(0,0,0,0.1);min-height:100vh;}");
    client.println("h1{color:#333;border-bottom:2px solid #4CAF50;padding-bottom:8px;font-size:18px;word-break:break-all;}");
    client.println(".info{background:#e7f3fe;border-left:4px solid #2196F3;padding:10px;margin:10px 0;font-size:13px;}");
    client.println(".preview-box{background:#1e1e1e;border:1px solid #333;border-radius:5px;padding:8px;margin:12px 0;height:400px;overflow-y:scroll;font-family:monospace;font-size:11px;color:#0f0;white-space:pre-wrap;word-wrap:break-word;line-height:1.0;}");
    client.println(".preview-box::-webkit-scrollbar{width:8px;}");
    client.println(".preview-box::-webkit-scrollbar-track{background:#2d2d2d;}");
    client.println(".preview-box::-webkit-scrollbar-thumb{background:#555;border-radius:4px;}");
    client.println(".preview-box::-webkit-scrollbar-thumb:hover{background:#777;}");
    client.println(".pagination{display:flex;flex-wrap:nowrap;gap:6px;align-items:center;justify-content:center;margin:15px 0;padding:10px 0;overflow-x:auto;}");
    client.println(".pagination button,.pagination a{padding:6px 10px;background:#2196F3;color:white;border:none;border-radius:4px;cursor:pointer;text-decoration:none;font-size:12px;transition:all 0.2s;white-space:nowrap;}");
    client.println(".pagination button:hover,.pagination a:hover{background:#1976D2;}");
    client.println(".pagination button:disabled{background:#ccc;cursor:not-allowed;}");
    client.println(".pagination .page-info{padding:6px 10px;background:#fff;border:1px solid #ddd;border-radius:4px;font-size:12px;white-space:nowrap;}");
    client.println(".pagination input[type='number']{width:50px;padding:4px;border:1px solid #ddd;border-radius:4px;text-align:center;font-size:12px;}");
    client.println(".actions{margin:15px 0;display:flex;flex-wrap:wrap;gap:8px;justify-content:center;}");
    client.println(".actions a{padding:8px 16px;background:#2196F3;color:white;text-decoration:none;border-radius:4px;font-size:13px;}");
    client.println(".actions a:hover{background:#1976D2;}");
    client.println("@media screen and (min-width: 600px){.container{max-width:900px;padding:15px;}.preview-box{height:500px;}}");
    client.println("@media screen and (max-width: 480px){.container{max-width:95%;padding:10px;}h1{font-size:16px;}}");
    client.println("</style></head><body>");
    client.println("<div class='container'>");
    client.println("<h1>" + fileName + "</h1>");
    
    client.println("<div class='info'>");
    client.println("<strong>路径:</strong> " + filePath + "<br>");
    client.println("<strong>大小:</strong> " + formatFileSize(fileSize) + "<br>");
    client.println("<strong>总行数:</strong> " + String(totalLines) + " 行<br>");
    client.println("<strong>当前页:</strong> " + String(page) + " / " + String(totalPages) + " 页");
    client.println("</div>");
    
    client.println("<div class='pagination'>");
    client.println("<a href='/preview?file=" + filePath + "&page=1'>&laquo; 首页</a>");
    if (page > 1) {
      client.println("<a href='/preview?file=" + filePath + "&page=" + String(page - 1) + "'>&lsaquo; 上页</a>");
    } else {
      client.println("<button disabled>&lsaquo; 上页</button>");
    }
    client.println("<span class='page-info'>第 <input type='number' id='pageInput' value='" + String(page) + "' min='1' max='" + String(totalPages) + "' onchange='gotoPage()'> / " + String(totalPages) + " 页</span>");
    if (page < totalPages) {
      client.println("<a href='/preview?file=" + filePath + "&page=" + String(page + 1) + "'>下页 &rsaquo;</a>");
    } else {
      client.println("<button disabled>下页 &rsaquo;</button>");
    }
    client.println("<a href='/preview?file=" + filePath + "&page=" + String(totalPages) + "'>尾页 &raquo;</a>");
    client.println("</div>");
    client.println("<script>function gotoPage(){var p=parseInt(document.getElementById('pageInput').value);if(p>=1&&p<=" + String(totalPages) + "){window.location.href='/preview?file=" + filePath + "&page='+p;}}</script>");
    
    client.println("<div class='preview-box'>");
    
    int linesRead = 0;
    while (file.available() && linesRead < linesPerPage) {
      char c = file.read();
      if (c == '\n') {
        client.print('\n');
        linesRead++;
      } else if (c == '\r') {
      } else {
        if (c == '<') client.print("&lt;");
        else if (c == '>') client.print("&gt;");
        else if (c == '&') client.print("&amp;");
        else if (c == '"') client.print("&quot;");
        else if (c == '\'') client.print("&#39;");
        else client.print(c);
      }
    }
    
    client.println("</div>");
    
    client.println("<div class='actions'>");
    client.println("<a href='/download?file=" + filePath + "'>下载文件</a>");
    client.println("<a href='/logs'>返回日志列表</a>");
    client.println("</div>");
    client.println("</div>");
    client.println("<script>window.onload=function(){var box=document.querySelector('.preview-box');if(box)box.scrollTop=box.scrollHeight;};</script>");
    client.println("</body></html>");
    file.close();
  } else {
    client.println("HTTP/1.1 404 Not Found");
    client.println("Content-Type: text/html");
    client.println();
    client.println("<!DOCTYPE html><html><head><meta charset='UTF-8'></head><body><h1>404 - 文件未找到</h1><p>请求的文件不存在: " + filePath + "</p><a href='/logs'>返回日志列表</a></body></html>");
  }
}

// ==================== 串口实时显示页面 ====================
void handleSerialPage(WiFiClient client) {
  String html = "HTTP/1.1 200 OK\r\nContent-Type: text/html\r\n\r\n";
  html += "<!DOCTYPE html><html><head><meta charset='UTF-8'>";
  html += "<meta name='viewport' content='width=device-width, initial-scale=1.0, user-scalable=yes'>";
  html += "<title>串口监视器 - ESP32 UART</title>";
  html += "<style>";
  html += "*{box-sizing:border-box;margin:0;padding:0;}";
  html += "body{font-family:'Consolas','Monaco',monospace;margin:0;background:#1e1e1e;color:#0f0;height:100vh;display:flex;flex-direction:column;}";
  html += ".header{background:#2d2d2d;padding:12px 15px;display:flex;justify-content:space-between;align-items:center;border-bottom:1px solid #444;}";
  html += ".header h1{color:#4CAF50;font-size:18px;}";
  html += ".header-info{color:#888;font-size:12px;}";
  html += ".serial-container{flex:1;display:flex;flex-direction:column;overflow:hidden;}";
  html += ".serial-output{flex:1;background:#1a1a1a;color:#0f0;padding:12px;overflow-y:auto;font-size:13px;line-height:1.5;word-wrap:break-word;white-space:pre-wrap;border:none;resize:none;}";
  html += ".serial-output::-webkit-scrollbar{width:10px;}";
  html += ".serial-output::-webkit-scrollbar-track{background:#2d2d2d;}";
  html += ".serial-output::-webkit-scrollbar-thumb{background:#555;border-radius:5px;}";
  html += ".serial-output::-webkit-scrollbar-thumb:hover{background:#777;}";
  html += ".input-area{background:#2d2d2d;padding:12px;display:flex;gap:8px;border-top:1px solid #444;}";
  html += ".input-area input[type='text']{flex:1;padding:10px 12px;background:#333;color:#fff;border:1px solid #555;border-radius:4px;font-size:14px;font-family:inherit;}";
  html += ".input-area input[type='text']:focus{outline:none;border-color:#4CAF50;}";
  html += ".input-area input[type='submit']{padding:10px 20px;background:#4CAF50;color:white;border:none;border-radius:4px;font-size:14px;cursor:pointer;transition:all 0.2s;}";
  html += ".input-area input[type='submit']:hover{background:#45a049;}";
  html += ".btn-clear{background:#f44336 !important;}";
  html += ".btn-clear:hover{background:#d32f2f !important;}";
  html += ".status-bar{background:#333;padding:8px 15px;font-size:12px;color:#888;display:flex;justify-content:space-between;}";
  html += ".online{color:#4CAF50;}";
  html += "@media screen and (max-width: 600px){";
  html += ".header{flex-direction:column;gap:8px;align-items:flex-start;}";
  html += ".input-area{flex-direction:column;}";
  html += ".input-area input[type='submit']{width:100%;}";
  html += ".serial-output{font-size:12px;}";
  html += "}";
  html += "</style></head><body>";
  html += "<div class='header'>";
  html += "<div style='display:flex;align-items:center;gap:10px;'>";
  html += "<a href='/' style='color:#4CAF50;text-decoration:none;font-size:14px;'>← 首页</a>";
  html += "<h1 style='margin:0;'>🖥️ 串口监视器</h1>";
  html += "</div>";
  html += "<div class='header-info'>UART2: " + String(uart2BaudRate) + " | UART1: " + String(uart1BaudRate) + " | 模式: " + String(currentMode == MODE_CLIENT ? "客户端" : "服务器") + "</div>";
  html += "</div>";
  html += "<div style='background:#333;padding:8px 15px;display:flex;gap:10px;align-items:center;flex-wrap:wrap;'>";
  html += "<span style='color:#888;font-size:12px;'>显示:</span>";
  html += "<select id='sourceSelect' onchange='changeSource()' style='background:#444;color:#fff;border:1px solid #555;padding:4px 8px;border-radius:4px;font-size:12px;'>";
  html += "<option value='server'>UART2/服务器</option>";
  for (int i = 0; i < MAX_CLIENTS; i++) {
    if (serverClients[i] && serverClients[i].connected()) {
      html += "<option value='client_" + String(i) + "'>客户端 " + String(i) + "</option>";
    }
  }
  html += "<option value='uart1'>UART1 (IO" + String(UART1_RX_PIN) + "/" + String(UART1_TX_PIN) + ")</option>";
  html += "</select>";
  html += "<span style='color:#888;font-size:12px;margin-left:10px;'>发送目标:</span>";
  html += "<select id='targetSelect' style='background:#444;color:#fff;border:1px solid #555;padding:4px 8px;border-radius:4px;font-size:12px;'>";
  html += "<option value='-1'>全部/本地UART2</option>";
  for (int i = 0; i < MAX_CLIENTS; i++) {
    if (serverClients[i] && serverClients[i].connected()) {
      String sel = (selectedClientIndex == i) ? " selected" : "";
      html += "<option value='" + String(i) + "'" + sel + ">客户端 " + String(i) + "</option>";
    }
  }
  html += "<option value='uart1'>UART1 (IO" + String(UART1_TX_PIN) + ")</option>";
  html += "</select>";
  html += "</div>";
  html += "<div class='serial-container'>";
  html += "<textarea class='serial-output' id='serialOutput' readonly></textarea>";
  html += "</div>";
  html += "<div class='input-area'>";
  html += "<input type='text' id='serialInput' placeholder='输入命令...' autocomplete='off'>";
  html += "<label style='color:#fff;font-size:12px;white-space:nowrap;'><input type='checkbox' id='addCr' style='margin-right:4px;'>CR(\\r)</label>";
  html += "<label style='color:#fff;font-size:12px;white-space:nowrap;'><input type='checkbox' id='addLf' checked style='margin-right:4px;'>LF(\\n)</label>";
  html += "<input type='submit' value='发送' onclick='sendData()'>";
  html += "<input type='submit' value='清空' class='btn-clear' onclick='clearSerial()'>";
  html += "</div>";
  html += "<div class='status-bar'>";
  html += "<span>连接状态: <span class='online' id='connStatus'>在线</span></span>";
  html += "<span id='bufferStatus'>缓冲区: 0 字符</span>";
  html += "<span>最后更新: <span id='lastUpdate'>--</span></span>";
  html += "</div>";
  html += "<script>";
  html += "var currentSource = 'server';";
  html += "var serialData = {server: '', client_0: '', client_1: '', client_2: '', client_3: '', client_4: '', uart1: ''};";
  html += "function changeSource(){";
  html += "  currentSource = document.getElementById('sourceSelect').value;";
  html += "  document.getElementById('serialOutput').value = serialData[currentSource] || '';";
  html += "  document.getElementById('serialOutput').scrollTop = document.getElementById('serialOutput').scrollHeight;";
  html += "  history.replaceState(null, '', '?source=' + currentSource);";
  html += "}";
  html += "function initSource(){";
  html += "  var params = new URLSearchParams(window.location.search);";
  html += "  var savedSource = params.get('source');";
  html += "  if(savedSource && document.getElementById('sourceSelect').querySelector('option[value=\"' + savedSource + '\"]')){";
  html += "    currentSource = savedSource;";
  html += "    document.getElementById('sourceSelect').value = currentSource;";
  html += "  }";
  html += "  document.getElementById('serialOutput').value = serialData[currentSource] || '';";
  html += "}";
  html += "var isFetching = false;";
  html += "function fetchSerialData(){";
  html += "  if(isFetching) return;";
  html += "  isFetching = true;";
  html += "  fetch('/serial/data?source=' + currentSource,{cache: 'no-store'}).then(r=>r.text()).then(data=>{";
  html += "    isFetching = false;";
  html += "    if(data.length > 0){";
  html += "      serialData[currentSource] += data;";
  html += "      if(serialData[currentSource].length > 50000){";
  html += "        serialData[currentSource] = serialData[currentSource].substring(serialData[currentSource].length - 40000);";
  html += "      }";
  html += "      var output = document.getElementById('serialOutput');";
  html += "      var wasAtBottom = output.scrollHeight - output.scrollTop <= output.clientHeight + 50;";
  html += "      output.value = serialData[currentSource];";
  html += "      if(wasAtBottom){";
  html += "        output.scrollTop = output.scrollHeight;";
  html += "      }";
  html += "      var now = new Date();";
  html += "      document.getElementById('lastUpdate').textContent = now.toLocaleTimeString();";
  html += "      document.getElementById('bufferStatus').textContent = '缓冲区: ' + (serialData[currentSource] || '').length + ' 字符';";
  html += "    }";
  html += "  }).catch(function(){isFetching = false;});";
  html += "}";
  html += "function sendData(){";
  html += "  var input = document.getElementById('serialInput');";
  html += "  if(input.value.trim() === '') return;";
  html += "  var target = document.getElementById('targetSelect').value;";
  html += "  var addCr = document.getElementById('addCr').checked ? '1' : '0';";
  html += "  var addLf = document.getElementById('addLf').checked ? '1' : '0';";
  html += "  var formData = 'data=' + encodeURIComponent(input.value) + '&target=' + target + '&cr=' + addCr + '&lf=' + addLf;";
  html += "  fetch('/serial/send', {method: 'POST', headers: {'Content-Type': 'application/x-www-form-urlencoded'}, body: formData}).then(function(response){";
  html += "    input.value = '';";
  html += "  });";
  html += "}";
  html += "function clearSerial(){";
  html += "  var body = 'source=' + currentSource;";
  html += "  fetch('/serial/clear', {method: 'POST', headers: {'Content-Type': 'application/x-www-form-urlencoded'}, body: body});";
  html += "  serialData[currentSource] = '';";
  html += "  document.getElementById('serialOutput').value = '';";
  html += "}";
  html += "document.getElementById('serialInput').addEventListener('keypress', function(e){";
  html += "  if(e.key === 'Enter'){";
  html += "    sendData();";
  html += "    e.preventDefault();";
  html += "  }";
  html += "});";
  html += "initSource();";
  html += "setInterval(fetchSerialData, 50);";
  html += "fetchSerialData();";
  html += "</script>";
  html += "</body></html>";
  client.print(html);
}

void handleSerialDataAPI(WiFiClient client, String request) {
  client.println("HTTP/1.1 200 OK");
  client.println("Content-Type: text/plain");
  client.println("Cache-Control: no-cache, no-store, must-revalidate");
  client.println();

  String response;
  if (request.indexOf("source=uart1") >= 0) {
    // UART1 独立缓冲区
    response = filterAnsiEscape(takeSerial1BufferSnapshot(true));
  } else {
    // 默认 UART2 / 服务器缓冲区
    response = filterAnsiEscape(takeSerialBufferSnapshot(true));
  }

  client.print(response);
}

void handleSerialSend(WiFiClient client, String request) {
  int dataIndex = request.indexOf("data=");
  if (dataIndex < 0) {
    return;
  }
  dataIndex += 5;
  int dataEnd = request.indexOf("&", dataIndex);
  if (dataEnd == -1) dataEnd = request.length();
  String data = request.substring(dataIndex, dataEnd);
  data = urlDecode(data);
  
  int targetIndex = -1;
  bool targetUart1 = false;
  int targetPos = request.indexOf("target=");
  if (targetPos >= 0) {
    targetPos += 7;
    int targetEnd = request.indexOf("&", targetPos);
    if (targetEnd == -1) targetEnd = request.length();
    String targetStr = request.substring(targetPos, targetEnd);
    targetStr.trim();
    if (targetStr == "uart1") {
      targetUart1 = true;
    } else {
      targetIndex = targetStr.toInt();
    }
  }
  
  bool addCr = false;
  int crPos = request.indexOf("cr=");
  if (crPos >= 0) {
    crPos += 3;
    addCr = (request.charAt(crPos) == '1');
  }
  
  bool addLf = true;
  int lfPos = request.indexOf("lf=");
  if (lfPos >= 0) {
    lfPos += 3;
    addLf = (request.charAt(lfPos) == '1');
  }

  bool explicitFrame = data.length() > 0 && data[0] == SECURITY_FRAME_HEADER_CHAR && data[data.length() - 1] == SECURITY_FRAME_TAIL_CHAR;
  if (!explicitFrame) {
    if (addCr) data += "\r";
    if (addLf) data += "\n";
  }

  String payload = "";
  String frame = explicitFrame ? data : buildSecureFrame(data);
  String errorReason = "";
  webFrameBuffer = "";
  bool payloadReady = frame.length() > 0 &&
                      appendIngressChunk(SECURITY_SOURCE_WEB, -1, (const uint8_t *)frame.c_str(), frame.length(), errorReason) &&
                      getValidatedPayload(SECURITY_SOURCE_WEB, -1, payload, errorReason);

  if (payloadReady && payload.length() > 0) {
    if (targetUart1) {
      // 发向 UART1
      sendValidatedPayloadToUART(UART_NUM_1, payload);
    } else if (currentMode == MODE_SERVER) {
      if (targetIndex >= 0 && targetIndex < MAX_CLIENTS) {
        selectedClientIndex = targetIndex;
        if (serverClients[targetIndex] && serverClients[targetIndex].connected()) {
          sendFramedPayloadToClient(serverClients[targetIndex], payload);
        }
      } else {
        sendValidatedPayloadToUART(UART_NUM_2, payload);
      }
    } else {
      sendValidatedPayloadToUART(UART_NUM_2, payload);
    }
  }
  
  String html = "HTTP/1.1 200 OK\r\nContent-Type: text/html\r\n\r\n";
  html += "<!DOCTYPE html><html><head><meta http-equiv='refresh' content='0;url=/serial '></head></html>";
  client.print(html);
}

void handleSerialClear(WiFiClient client, String postBody) {
  if (postBody.indexOf("source=uart1") >= 0) {
    clearSerial1Buffer();
  } else {
    clearSerialBuffer();
  }

  String html = "HTTP/1.1 200 OK\r\nContent-Type: text/html\r\n\r\n";
  html += "<!DOCTYPE html><html><head></head><body></body></html>";
  client.print(html);
}

void clearSerialBuffer() {
  portENTER_CRITICAL(&serialDisplayBufferMux);
  serialDisplayBufferLen = 0;
  serialDisplayBuffer[0] = '\0';
  portEXIT_CRITICAL(&serialDisplayBufferMux);
}

String takeSerialBufferSnapshot(bool clearBuffer) {
  char localBuffer[SERIAL_DISPLAY_BUFFER_SIZE + 1];
  size_t snapshotLen = 0;

  portENTER_CRITICAL(&serialDisplayBufferMux);
  snapshotLen = serialDisplayBufferLen;
  memcpy(localBuffer, serialDisplayBuffer, snapshotLen);
  localBuffer[snapshotLen] = '\0';

  if (clearBuffer) {
    serialDisplayBufferLen = 0;
    serialDisplayBuffer[0] = '\0';
  }
  portEXIT_CRITICAL(&serialDisplayBufferMux);

  return String(localBuffer);
}

void appendToSerialBuffer(char c) {
  if (c == '\r') {
    return;
  }

  appendToSerialBuffer(&c, 1);
}

void appendToSerialBuffer(const char* str) {
  if (!str) {
    return;
  }

  appendToSerialBuffer(str, strlen(str));
}

void appendToSerialBuffer(const char* str, int len) {
  if (!str || len <= 0) {
    return;
  }

  portENTER_CRITICAL(&serialDisplayBufferMux);
  for (int i = 0; i < len; i++) {
    if (str[i] == '\r') {
      continue;
    }

    if (serialDisplayBufferLen >= SERIAL_DISPLAY_BUFFER_SIZE) {
      size_t keepLen = SERIAL_DISPLAY_BUFFER_SIZE / 2;
      size_t dropLen = serialDisplayBufferLen - keepLen;
      memmove(serialDisplayBuffer, serialDisplayBuffer + dropLen, keepLen);
      serialDisplayBufferLen = keepLen;
    }

    serialDisplayBuffer[serialDisplayBufferLen++] = str[i];
  }
  serialDisplayBuffer[serialDisplayBufferLen] = '\0';
  portEXIT_CRITICAL(&serialDisplayBufferMux);
}

// 处理串口数据请求（兼容旧接口）
void handleSerialData(WiFiClient client) {
  handleSerialPage(client);
}

// ==================== UART1 独立缓冲区操作 ====================
void clearSerial1Buffer() {
  portENTER_CRITICAL(&serial1DisplayBufferMux);
  serial1DisplayBufferLen = 0;
  serial1DisplayBuffer[0] = '\0';
  portEXIT_CRITICAL(&serial1DisplayBufferMux);
}

String takeSerial1BufferSnapshot(bool clearBuffer) {
  char localBuffer[SERIAL_DISPLAY_BUFFER_SIZE + 1];
  size_t snapshotLen = 0;

  portENTER_CRITICAL(&serial1DisplayBufferMux);
  snapshotLen = serial1DisplayBufferLen;
  memcpy(localBuffer, serial1DisplayBuffer, snapshotLen);
  localBuffer[snapshotLen] = '\0';

  if (clearBuffer) {
    serial1DisplayBufferLen = 0;
    serial1DisplayBuffer[0] = '\0';
  }
  portEXIT_CRITICAL(&serial1DisplayBufferMux);

  return String(localBuffer);
}

void appendToSerial1Buffer(char c) {
  if (c == '\r') return;
  appendToSerial1Buffer(&c, 1);
}

void appendToSerial1Buffer(const char* str) {
  if (!str) return;
  appendToSerial1Buffer(str, strlen(str));
}

void appendToSerial1Buffer(const char* str, int len) {
  if (!str || len <= 0) return;

  portENTER_CRITICAL(&serial1DisplayBufferMux);
  for (int i = 0; i < len; i++) {
    if (str[i] == '\r') continue;

    if (serial1DisplayBufferLen >= SERIAL_DISPLAY_BUFFER_SIZE) {
      size_t keepLen = SERIAL_DISPLAY_BUFFER_SIZE / 2;
      size_t dropLen = serial1DisplayBufferLen - keepLen;
      memmove(serial1DisplayBuffer, serial1DisplayBuffer + dropLen, keepLen);
      serial1DisplayBufferLen = keepLen;
    }

    serial1DisplayBuffer[serial1DisplayBufferLen++] = str[i];
  }
  serial1DisplayBuffer[serial1DisplayBufferLen] = '\0';
  portEXIT_CRITICAL(&serial1DisplayBufferMux);
}

void handleDeleteFile(WiFiClient client, String request) {
  int fileStart = request.indexOf("file=") + 5;
  int fileEnd = request.indexOf(" ", fileStart);
  if (fileEnd == -1) fileEnd = request.length();
  String filePath = request.substring(fileStart, fileEnd);
  filePath = urlDecode(filePath);
  
  // 规范化路径：移除多余的斜杠
  while (filePath.indexOf("//") >= 0) {
    filePath.replace("//", "/");
  }
  
  // 安全检查：防止路径遍历攻击
  if (filePath.indexOf("..") != -1) {
    client.println("HTTP/1.1 403 Forbidden");
    client.println("Content-Type: text/html");
    client.println();
    client.println("<!DOCTYPE html><html><head><meta charset='UTF-8'></head><body><h1>403 - 禁止访问</h1><a href='/logs'>返回日志列表</a></body></html>");
    return;
  }
  
  // 允许删除 /server/ 和 /client/ 路径下的文件
  if (!filePath.startsWith("/server/") && !filePath.startsWith("/client/")) {
    client.println("HTTP/1.1 403 Forbidden");
    client.println("Content-Type: text/html");
    client.println();
    client.println("<!DOCTYPE html><html><head><meta charset='UTF-8'></head><body><h1>403 - 禁止访问</h1><a href='/logs'>返回日志列表</a></body></html>");
    return;
  }
  
  if (SD.exists(filePath)) {
    if (SD.remove(filePath)) {
      client.println("HTTP/1.1 302 Found");
      client.println("Location: /logs");
      client.println();
    } else {
      client.println("HTTP/1.1 500 Internal Server Error");
      client.println("Content-Type: text/html");
      client.println();
      client.println("<!DOCTYPE html><html><head><meta charset='UTF-8'></head><body><h1>删除失败</h1><a href='/logs'>返回日志列表</a></body></html>");
    }
  } else {
    client.println("HTTP/1.1 404 Not Found");
    client.println("Content-Type: text/html");
    client.println();
    client.println("<!DOCTYPE html><html><head><meta charset='UTF-8'></head><body><h1>文件不存在</h1><a href='/logs'>返回日志列表</a></body></html>");
  }
}

void handleDeleteDirectory(WiFiClient client, String request) {
  int dirStart = request.indexOf("dir=") + 4;
  int dirEnd = request.indexOf(" ", dirStart);
  if (dirEnd == -1) dirEnd = request.length();
  String dirPath = request.substring(dirStart, dirEnd);
  dirPath = urlDecode(dirPath);
  
  // 规范化路径：移除多余的斜杠
  while (dirPath.indexOf("//") >= 0) {
    dirPath.replace("//", "/");
  }
  
  // 安全检查：防止路径遍历攻击
  if (dirPath.indexOf("..") != -1) {
    client.println("HTTP/1.1 403 Forbidden");
    client.println("Content-Type: text/html");
    client.println();
    client.println("<!DOCTYPE html><html><head><meta charset='UTF-8'></head><body><h1>403 - 禁止访问</h1><a href='/logs'>返回日志列表</a></body></html>");
    return;
  }
  
  if (!dirPath.startsWith("/server") && !dirPath.startsWith("/client")) {
    client.println("HTTP/1.1 403 Forbidden");
    client.println("Content-Type: text/html");
    client.println();
    client.println("<!DOCTYPE html><html><head><meta charset='UTF-8'></head><body><h1>403 - 禁止访问</h1><a href='/logs'>返回日志列表</a></body></html>");
    return;
  }
  
  if (SD.exists(dirPath)) {
    if (deleteDirectoryRecursive(dirPath)) {
      client.println("HTTP/1.1 302 Found");
      client.println("Location: /logs");
      client.println();
    } else {
      client.println("HTTP/1.1 500 Internal Server Error");
      client.println("Content-Type: text/html");
      client.println();
      client.println("<!DOCTYPE html><html><head><meta charset='UTF-8'></head><body><h1>删除失败</h1><a href='/logs'>返回日志列表</a></body></html>");
    }
  } else {
    client.println("HTTP/1.1 302 Found");
    client.println("Location: /logs");
    client.println();
  }
}

bool deleteDirectoryRecursive(String path) {
  File root = SD.open(path);
  if (!root) return false;
  
  if (!root.isDirectory()) {
    root.close();
    return false;
  }
  
  bool success = true;
  while (true) {
    File entry = root.openNextFile();
    if (!entry) break;
    
    String entryPath = path + "/" + entry.name();
    
    if (entry.isDirectory()) {
      if (!deleteDirectoryRecursive(entryPath)) {
        success = false;
      }
    } else {
      if (!SD.remove(entryPath)) {
        success = false;
      }
    }
    entry.close();
  }
  root.close();
  
  if (success) {
    if (!SD.rmdir(path)) {
      success = false;
    }
  }
  
  return success;
}
