xqplfly/uart-wifi-transmissible/(commit log)

2026-03-30 perf: 优化网页串口轮询性能 - 轮询间隔从100ms缩短到50ms - 使用fetch API替代XMLHttpRequest减少开销
2026-03-30 feat: 添加AT+CPU命令查看CPU和内存状态 - 显示CPU频率、核心数、芯片信息 - 显示堆内存使用情况和PSRAM信息 - 显示运行时间
2026-03-30 perf: 优化网页串口轮询机制 - 添加请求状态标志防止堆积 - 添加cache: 'no-store'确保获取最新数据
2026-03-30 feat: 服务器默认不显示客户端数据 - 只有AT+SELECT选择客户端后才透传到UART0和UART2
2026-03-30 fix: 添加selectedClientIndex外部变量声明
2026-03-30 fix: 修复网页发送命令返回404错误 - 改用fetch API发送POST请求 - 保持与轮询请求一致
    [web_server.ino]
2026-03-30 feat: 添加日志时间戳功能 - AT+LOGTIME=ON/OFF控制开关 - 支持EEPROM保存设置 - 网页配置页面添加开关
2026-03-30 feat: 开机串口默认不打印完整帮助信息，只显示简短提示
2026-03-30 fix: SD卡状态日志根据debugMode控制打印
2026-03-30 perf: 优化透传延迟 - TCP发送缓冲区从1KB增加到4KB - DMA任务中立即刷新TCP缓冲区减少延迟
2026-03-30 perf: 优化主循环处理顺序 - 优先处理TCP数据降低透传延迟 - 将TCP/透传处理提前，Web和SD卡处理延后
2026-03-30 perf: 优化SD卡检查频率 - 改为每5秒检查一次 - 用SD.exists替代SD.open减少开销 - 移除LED闪烁延迟 - 添加DMA溢出限流打印
2026-04-22 perf: 优化客户端透传性能 - WiFi连接改为非阻塞 - debugMode默认关闭 - 添加yield避免预览卡顿
2026-04-22 fix: improve UART responsiveness and quiet release output
    [battery_sd_management.ino, client_server_mode.ino, config_management.ino, dual-mode-uart-enhanced.ino, uart_interrupt.ino, uart_utility.ino, web_server.ino]
2026-04-22 fix: apply posted config and local AT handling
    [dual-mode-uart-enhanced.ino, uart_utility.ino, web_server.ino]
2026-04-22 fix: limit local commands to AT+ prefix
    [uart_utility.ino]
2026-05-22 fix: optimize serial buffer concurrency and build script
    [client_server_mode.ino, dual-mode-uart-enhanced.ino, web_server.ino]
2026-05-22 feat: add UART1 independent channel on GPIO19/20
    - Add UART1 DMA task (uart_interrupt.ino) pinned to Core 1, priority 11
    - Add serial1DisplayBuffer with portMUX isolation from UART2 buffer
    - Add UART1 SD logging to /client_u1/ and /server/uart1/ directories
    - Add SDLogEntry.uartChannel field for independent path routing
    - Add UART1 EEPROM baud persistence (address 50-53)
    - Add web API source=uart1 routing in handleSerialDataAPI/handleSerialClear
    - Add target=uart1 support in handleSerialSend
    - Add UART1 tab in serial monitor source/target selects
    - Add AT+BAUD1 command and AT+STATUS UART1 info
2026-05-22 feat: add framed uart ingress hardening
2026-05-25 docs: expand LED功能说明
2026-05-25 Update LED logic
2026-05-25 fix: correct battery ADC calculation and add percentage display
    Improve battery voltage conversion to match the actual divider and add a lithium battery percentage readout based on a 3.7V nominal reference.
    [battery_sd_management.ino]
2026-05-25 Fix SD Card Bug
    [battery_sd_management.ino]
